acki1989/Vitodens-ESP32-CAN-Gateway-HA/hardware/gehaeuse/ESP32-C3_CAN-Gehaeuse-Boden.stl

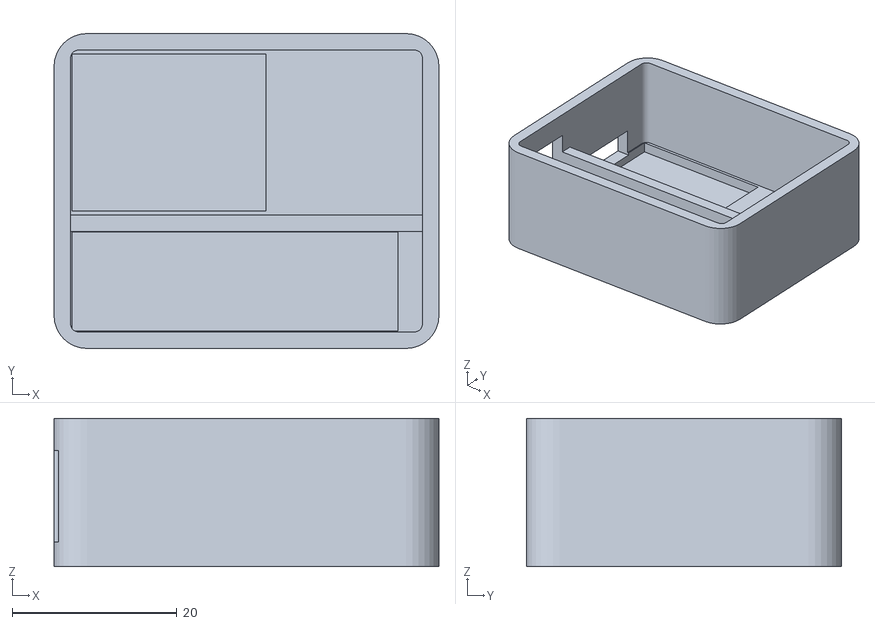
[picture p2: CAD file, 2026-11-02]
hardware/gehaeuse/ESP32-C3_CAN-Gehaeuse-Boden.stl
46.7 x 38.2 x 18.0
