acki1989/Vitodens-ESP32-CAN-Gateway-HA/(commit log)

2026-10-29 Firmware, Dokumentation und Lizenz
    - ESPHome-Konfiguration (vitodens-can.yaml) und UDS/ISO-TP-Client (vitodens-uds.h)
    - 22 Datenpunkte der Vitodens, 52 Entitaeten, Schreibzugriff auf die Heizkurve
    mit Freigabeschalter
    - README: Hardware, Protokoll, Inbetriebnahme, Diagnose, Stolperfallen
    - Apache-2.0 Lizenz und NOTICE zur Herkunft der open3e-Datenpunktdefinitionen
    - DID-Liste als Anhang in docs/
2026-11-01 Fix: UDS-DID big-endian, Adress-Scan, Betriebsdiagnose
    Der DID-Abgleich in der Antwort war little-endian - dadurch wurde jede
    gueltige Antwort verworfen und lief in den Timeout, obwohl ACK und Antwort
    kamen. Jetzt big-endian, wie UDS es vorgibt.
    - be_u16() fuer DID/NRC-Vergleich (Nutzdaten bleiben little-endian)
    - Adress-Scan 0x680..0x6EF mit DID 256, per Button startbar (nicht beim Boot)
    - Empfangsfilter akzeptiert 0x690..0x69F (alle ECU-Antworten)
    - NAN wird nicht mehr an HA gesendet (ValueError bei device_class)
    - on_boot auf Prioritaet -100: erst WLAN/API, dann CAN
    - Gateway-MAC-Sensor: 60 s statt 300 s
    - state_class measurement ohne device_class energy/gas (rollierende Fenster)
    - READM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
    [vitodens-can.yaml, vitodens-uds.h]
2026-11-01 Schreibbestaetigung: DID 880 nach dem Schreiben erneut lesen
    Nach einem erfolgreichen 0x2E wird der Datenpunkt 2 s spaeter erneut gelesen.
    Damit ist im HA-Number sofort sichtbar, ob der Wert wirklich angekommen ist,
    statt erst im naechsten 300-s-Zyklus.
    Rundlauf 0,4 -> 0,5 -> 0,4 am Geraet verifiziert.
2026-11-01 Haertung und Aufraeumen (Paket A)
    - Log-Bremse in fail_(): pro DID max. eine Warnzeile pro Minute, Zaehler
    laufen unveraendert weiter
    - Single-Frame: Nutzlaenge gegen die tatsaechliche DLC pruefen
    - fresh_any() mit 1-s-Cache (wurde ~60x/s aus dem Binaersensor aufgerufen)
    - benannte Konstanten statt 150/2000 ms im Code
    - tote API entfernt (ok(), write_pending()), doppelte NRC-Pruefung zusammengelegt
    - 18 dekodierte, nie veroeffentlichte Felder entfernt (min/max/avg,
    past_month/past_year)
    - request_curve() prueft den Wertebereich 0,2..3,5 selbst
    Am Geraet verifiziert: Werte lesen, Schreibvorgang 0x6E, 0 CAN-Fehler.
    [vitodens-uds.h]
2026-11-01 Docs: DID-Referenz auf Stand der Inbetriebnahme
    - Adressierung, Antwort-IDs und Endianness (DID big-endian, Nutzdaten little-endian)
    - Byte-Laengen korrigiert (364 = 6 B statt 1, 880 = 4 B statt 9, 1346 = 12 B)
    - Beispielwerte vom 01.11.2026 statt der alten Momentaufnahme
    - Schreibverfahren DID 880 inkl. bestaetigtem Rundlauf 0,4 -> 0,5 -> 0,4
    - Adress-Scan-Ergebnis: 0x680/0x684/0x688 antworten auf DID 256
2026-11-01 Heizkurve: Niveau schreibbar, Fuss-Skalierung korrigiert
    - neues Number-Entity 'Heizkurve 1 Niveau' (-13..40 K, Schritt 1) auf Byte 1
    von DID 880, gleiche Schreibfreigabe und gleiches Read-Modify-Write
    - Schreibpfad verallgemeinert: Byte-Index statt fest Byte 0
    - Fix: Fuss-Punkt wurde ohne /10 dekodiert (O3EInt16 hat scale=10) und zeigte
    -300,0 statt -30,0 Grad
    - README/Docs: 55 Entitaeten, Byte-Layout von 880, zwei Stellwerte
    Am Geraet verifiziert: Niveau 3,0 gelesen und mit 0x6E zurueckgeschrieben.
    [vitodens-can.yaml, vitodens-uds.h]
2026-11-01 Modulation (DID 526) und HA-Begleitung dokumentiert
    - neuer Datenpunkt 526 ModulationCurrentValue (int16 /10, Prozent, ro)
    im 30-s-Takt -> 23 DIDs, 58 Entitaeten
    - README: Abschnitt zur HA-Begleitung (Dashboard-Views, Skripte,
    statistics/history_stats-Sensoren, plotly-Ressource)
    - docs/dids-heizung.md: DID 526 ergaenzt, Summe auf 23 korrigiert
    Am Geraet verifiziert: Modulation wird gelesen (0 % bei Brenner aus).
    [vitodens-can.yaml, vitodens-uds.h]
2026-11-01 Gasverbrauch als Energie-Dashboard-Quelle
    - Gasverbrauch Heizung Jahr: device_class gas + total_increasing (statt
    measurement), damit die Entitaet als Gaszaehler im Energie-Dashboard
    akzeptiert wird
    - README: Hinweis zur Gasquelle und zum Jahres-Reset
    Validiert ueber hab energy validate: keine Beanstandung fuer die Gasquelle.
    [vitodens-can.yaml]
2026-11-02 3D-Druck-Gehäuse für ESP32-C3 und SN65HVD230 ergänzt
    [ESP32-C3_CAN-Gehaeuse-Boden.stl, ESP32-C3_CAN-Gehaeuse-Deckel.stl]
2026-11-02 Installationsanleitung ausführlich, direkt nach der Hardware
